manoj153/PersonalKKICADlib/ButterflyBOM.ods

 | Butterfly v.01a
Part | Value | Package | Library | Position | (inch) | Orientation
C1 | 5.6pF 50 V NPO (COG) | 0402-CAP | SparkFun-Capacitors | (0.16 | 0.861) | R180
C2 | 5.6pF 50 V NPO (COG) | 0402-CAP | SparkFun-Capacitors | (0.16 | 0.719) | R180
C3 | 100nF 16 V XR5 | 0402-CAP | SparkFun-Capacitors | (0.175 | 0.175) | R0
C4 | 1uF 16 V XR5 | 0402-CAP | SparkFun-Capacitors | (0.16 | 0.628) | R0
C5 | 10nF 25 V XR7 | 0402-CAP | SparkFun-Capacitors | (0.16 | 0.674) | R0
C6 | 4.7uF 10 V XR5 | 0402-CAP | SparkFun-Capacitors | (0.485 | 0.5) | R0
C7 | 100nF 16 V XR5 | 0402-CAP | SparkFun-Capacitors | (0.485 | 0.55) | R0
C8 | 100nF 16 V XR5 | 0402-CAP | SparkFun-Capacitors | (0.252 | 0.91) | R180
C9 | 100nF 16 V XR5 | 0402-CAP | SparkFun-Capacitors | (0.545 | 0.84) | R90
C17 | 1uF 16 V XR5 | 0402-CAP | SparkFun-Capacitors | (0.23 | 0.35) | R0
C18 | 1uF 16 V XR5 | 0402-CAP | SparkFun-Capacitors | (0.23 | 0.23) | R0
D1 | SBR05U20LP-7 | SBR05U20LP-7 | Kris | (0.29 | 0.345) | R180 | 0.5 A 20 V Schottky Diodes
D2 | SBR05U20LP-7 | SBR05U20LP-7 | Kris | (0.29 | 0.272) | R0 | 0.5 A 20 V Schottky Diodes
D4 | HSP061-2N4 | HSP061-2N4 | Kris | (0.365 | 0.31) | MR270
J1 | 1981584-1 | 1981584-1 | con-usb | (0.3525 | 0) | MR0
JP1 | 1X05_NO_SILK | SparkFun-Connectors | (0.1525 | 1.3525) | R0
JP2 | M02-JST-2-PTH-NO_SILK | JST-2-PTH-NS | SparkFun-Connectors | (0.191 | 0.466) | R270
JP3 | 1X06_NO_SILK | SparkFun-Connectors | (0.0525 | 0.0525) | R90
JP4 | 1X03_NO_SILK | SparkFun-Connectors | (0.4525 | 1.0525) | R90
JP5 | 1X06_NO_SILK | SparkFun-Connectors | (0.6525 | 0.5525) | R270
JP6 | 1X08_NO_SILK | SparkFun-Connectors | (0.0525 | 0.6525) | R90
JP7 | 1X08_NO_SILK | SparkFun-Connectors | (0.6525 | 1.3525) | R270
JP8 | 1X03_NO_SILK | SparkFun-Connectors | (0.5525 | 1.2525) | R270
L1 | BLM15HG601SN1D | 402 | inductors | (0.16 | 0.582) | R0 | 0402 600 Ohms Ferrite Bead |  | http://www.mouser.com/ProductDetail/Murata-Electronics/BLM15HG601SN1D/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
L3 | BLM15HG601SN1D | 402 | inductors | (0.565 | 0.17) | MR180 | 402 600 Ohms Ferrite Bead |  | http://www.mouser.com/ProductDetail/Murata-Electronics/BLM15HG601SN1D/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
R2 | 4K7 | 0402-RES | SparkFun-Resistors | (0.16 | 0.24) | R90
R3 | 1K | 0402-RES | SparkFun-Resistors | (0.337 | 1.157) | R90
R4 | 1K | 0402-RES | SparkFun-Resistors | (0.282 | 1.216) | R180
R5 | 1K | 0402-RES | SparkFun-Resistors | (0.227 | 1.157) | R90
R6 | 10K | 0402-RES | SparkFun-Resistors | (0.53 | 0.175) | R0
RA1 | 22 Ohm 2x resistor array | EXB24V 0404 | Kris | (0.365 | 0.25) | MR0 |  | http://www.mouser.com/ProductDetail/Panasonic/EXB-24V220JX/
SJ1 | SOLDERJUMPERTRACE | SJ_2S-TRACE | SparkFun-Passives | (0.15 | 0.3) | MR90
SJ3 | SOLDERJUMPER-OLDTRACE | SJ_2S-TRACE | SparkFun-Passives | (0.53 | 0.255) | MR0
U$2 | PTS810 SJM 250 SMTR LFS | C&KTACTILESWITCH | Kris | (0.24 | 0.08) | R0 | 1.6 N Black button |  | http://www.mouser.com/ProductDetail/CK-Components/PTS810-SJM-250-SMTR-LFS/
U$3 | PTS810 SJM 250 SMTR LFS | C&KTACTILESWITCH | Kris | (0.46 | 0.08) | R0 | 1.6 N Black button |  | http://www.mouser.com/ProductDetail/CK-Components/PTS810-SJM-250-SMTR-LFS/
U$4 | GREEN | 0402LED | Kris | (0.16 | 0.32) | R90
U$5 | HN01 | HN01 | PWSONN6 | (0.205 | 1.0025) | R0
U1 | STM32L433CCU6 | STM32L433CCU6 | STM32L433CCU6 | (0.3725 | 0.725) | R0
U2 | LUMEX0404RGBLED | LX0404 | Kris | (0.282 | 1.161) | R0 |  | http://www.mouser.com/ProductDetail/Lumex/SML-LX0404SIUPGUSB/?qs=iPumNTI%2f3jXoZkWlWVrBPw%3d%3d
U5 | NCV8170 3V3 150 mA LDO | NCV8170 3V3 150 mA LDO | Kris | (0.23 | 0.29) | R0 |  | http://www.mouser.com/ProductDetail/ON-Semiconductor/NCV8170AMX330TCG/
X1 | ST2012SB 4 pF | ST2012SB32768Z0HPWBB | Kris | (0.156 | 0.79) | R90 | 4 pF only | http://www.mouser.com/ProductDetail/AVX/ST2012SB32768Z0HPWBB/
 | No Substitution please
