manoj153/PersonalKKICADlib/2.1MM BARREL JACK/DC Power Jack 5.5mm x 2.1mm.STEP

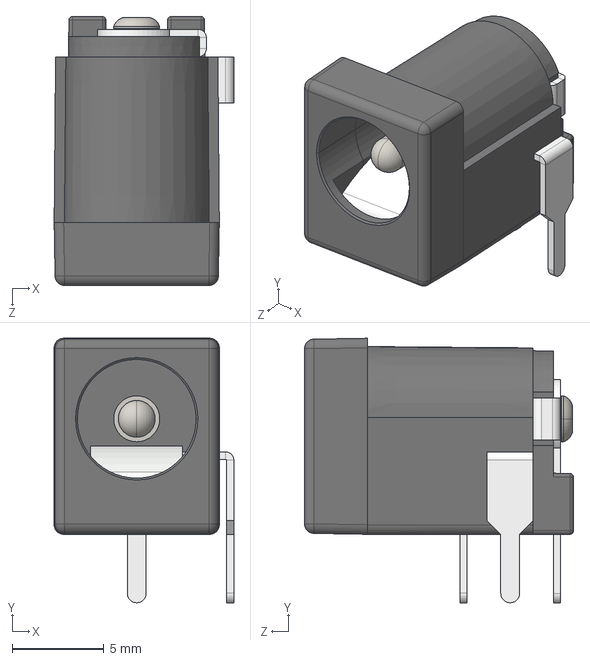
[picture p1: CAD file, 2020-03-30]
2.1MM BARREL JACK/DC Power Jack 5.5mm x 2.1mm.STEP
9.77 x 14.4 x 14.6 mm
