manoj153/PersonalKKICADlib/DRV5032AJDBZR/DRV5032AJDBZR.stp

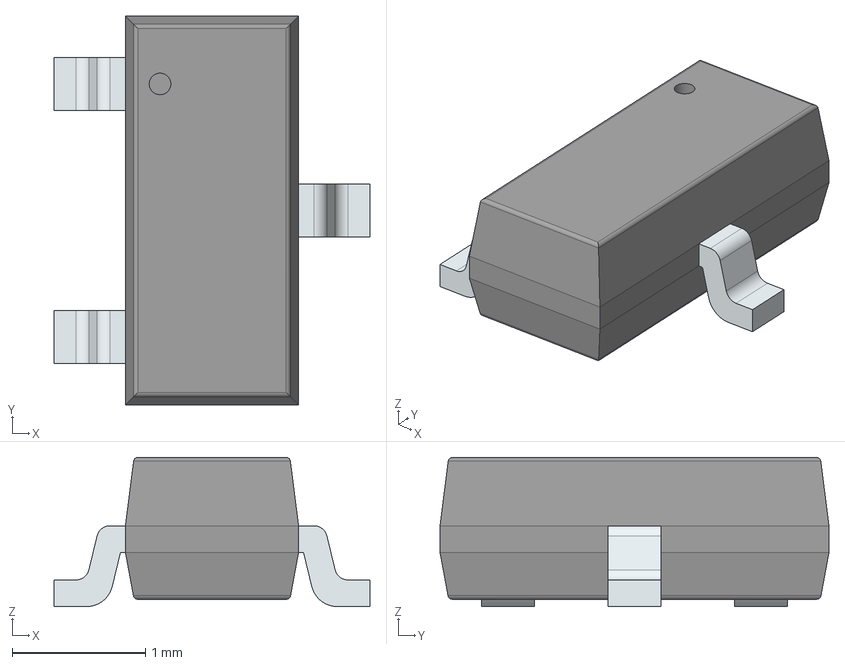
[picture p2: CAD file, 2020-05-10]
DRV5032AJDBZR/DRV5032AJDBZR.stp
2.37 x 2.92 x 1.12 mm
PinsArrayL
FilletPinR
