manoj153/PersonalKKICADlib/ESDA25W/ESDA25W.stl

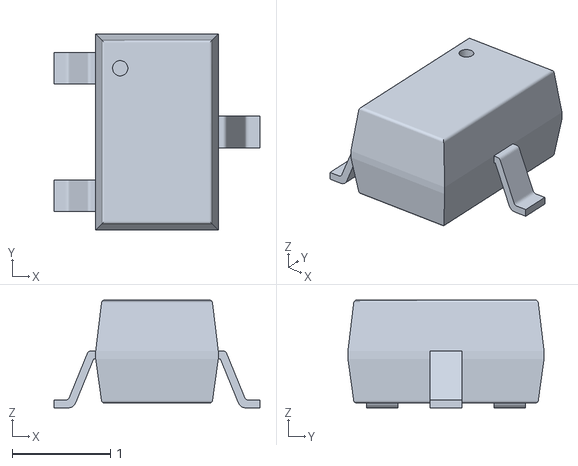
[picture p3: CAD file, 2019-06-10]
ESDA25W/ESDA25W.stl
2.10 x 2.00 x 1.10
