manoj153/PersonalKKICADlib/FUSE-AC/User Library-LF-102071.step

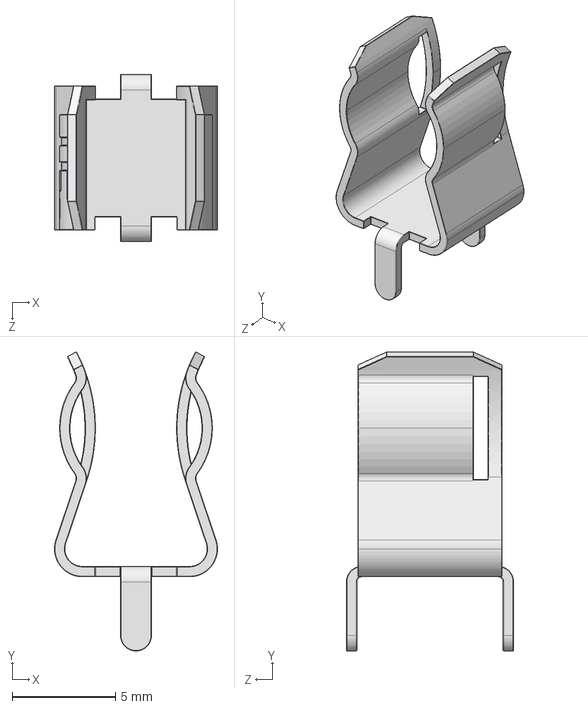
[picture p4: CAD file, 2019-06-16]
FUSE-AC/User Library-LF-102071.step
7.90 x 14.5 x 8.10 mm
