manoj153/PersonalKKICADlib/G6K-2F-Y-DC5/G6K_2F_Y_STEP/G6K_2F_Y.step

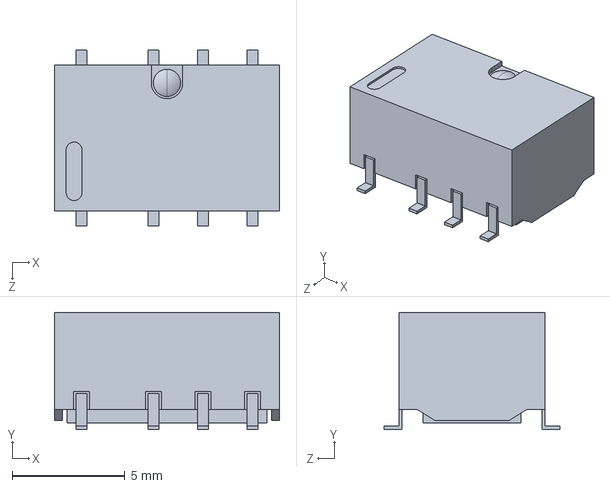
[picture p5: CAD file, 2019-06-10]
G6K-2F-Y-DC5/G6K_2F_Y_STEP/G6K_2F_Y.step
10.0 x 5.20 x 7.80 mm
