manoj153/PersonalKKICADlib/KK254-5WAY/22-05-3051.stp

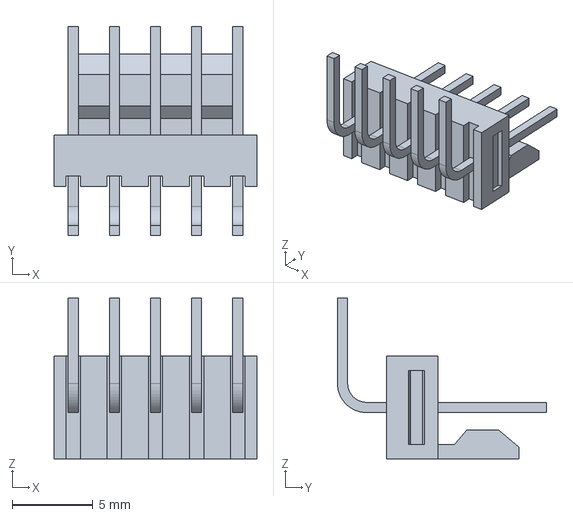
[picture p6: CAD file, 2019-06-10]
KK254-5WAY/22-05-3051.stp
12.5 x 12.9 x 9.93 mm
