manoj153/PersonalKKICADlib/KK254_HORIZONTAL/22-05-7028.stp

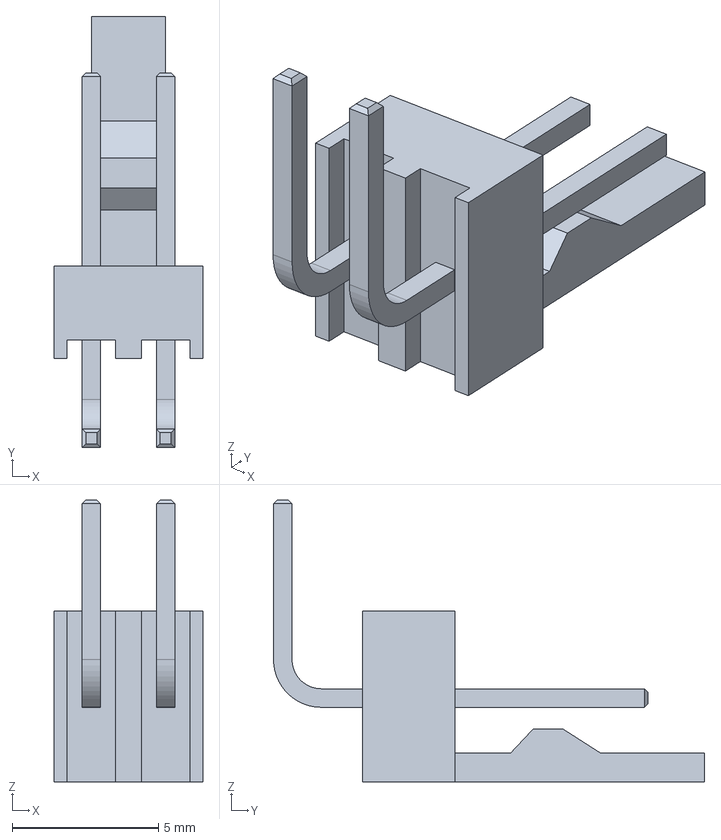
[picture p7: CAD file, 2019-06-10]
KK254_HORIZONTAL/22-05-7028.stp
5.08 x 14.7 x 9.64 mm
