manoj153/PersonalKKICADlib/MT48LC4M32B2P-6A_IT_L_TR/3D/MT48LC4M32B2P-6A_IT_L_TR.stp

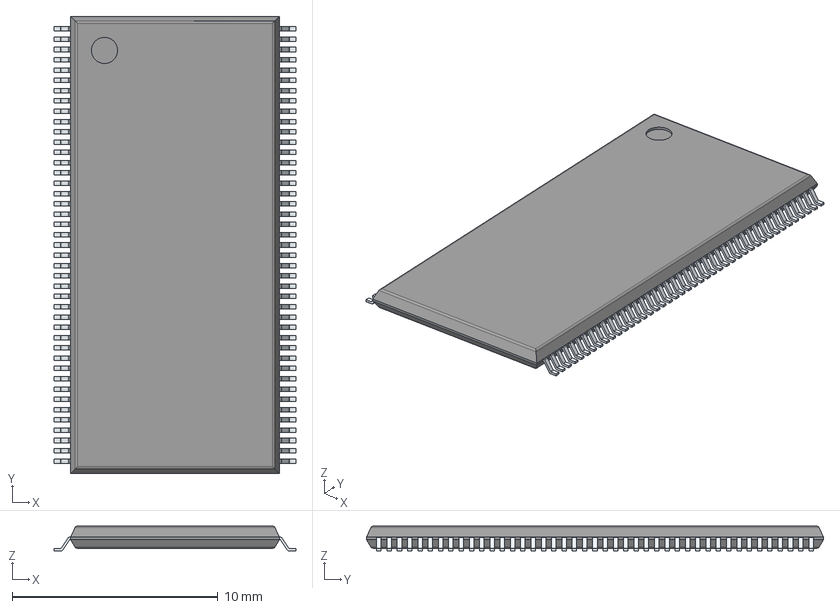
[picture p8: CAD file, 2020-08-13]
MT48LC4M32B2P-6A_IT_L_TR/3D/MT48LC4M32B2P-6A_IT_L_TR.stp
11.8 x 22.2 x 1.20 mm
PinsArrayLR
