manoj153/PersonalKKICADlib/NX3225GD-8MHZ-STD-CRA-3/3D/NX3225GD-8MHZ-STD-CRA-3.stp

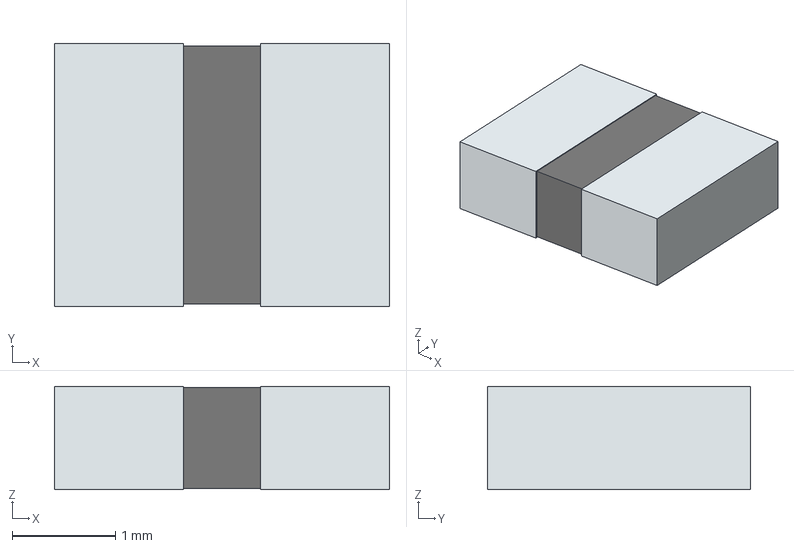
[picture p9: CAD file, 2020-08-13]
NX3225GD-8MHZ-STD-CRA-3/3D/NX3225GD-8MHZ-STD-CRA-3.stp
3.25 x 2.55 x 1.00 mm
term1
term2
