manoj153/PersonalKKICADlib/RZ03-1A4-D005/RZ03-1A4-D005--3DModel-STEP-56544.STEP

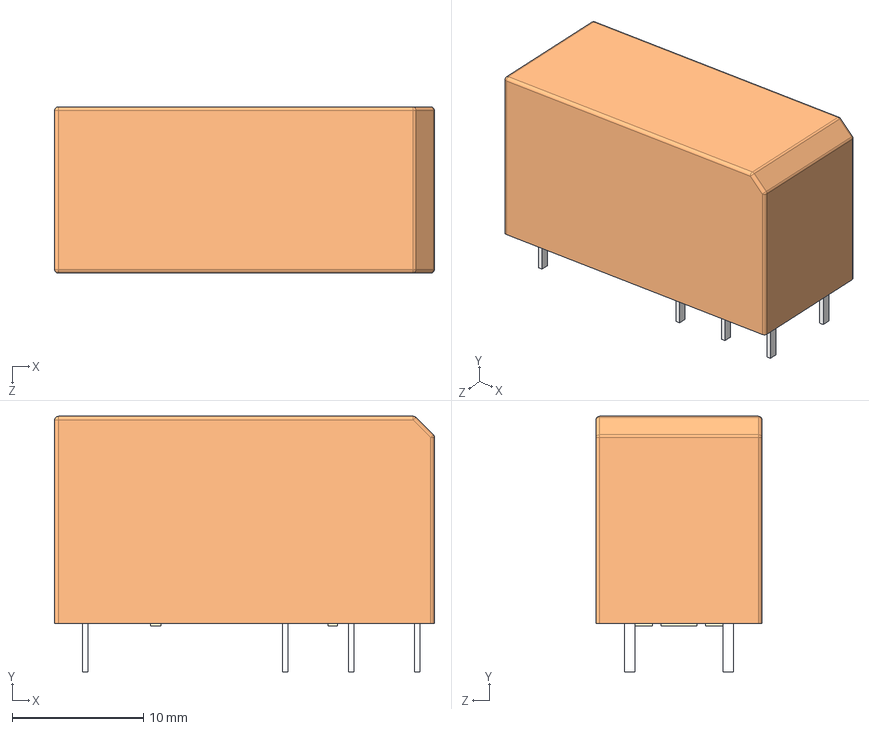
[picture p10: CAD file, 2019-06-10]
RZ03-1A4-D005/RZ03-1A4-D005--3DModel-STEP-56544.STEP
29.0 x 19.5 x 12.7 mm
