manoj153/PersonalKKICADlib/STM32L433CCU6/3D/STM32L433CCU6.stp

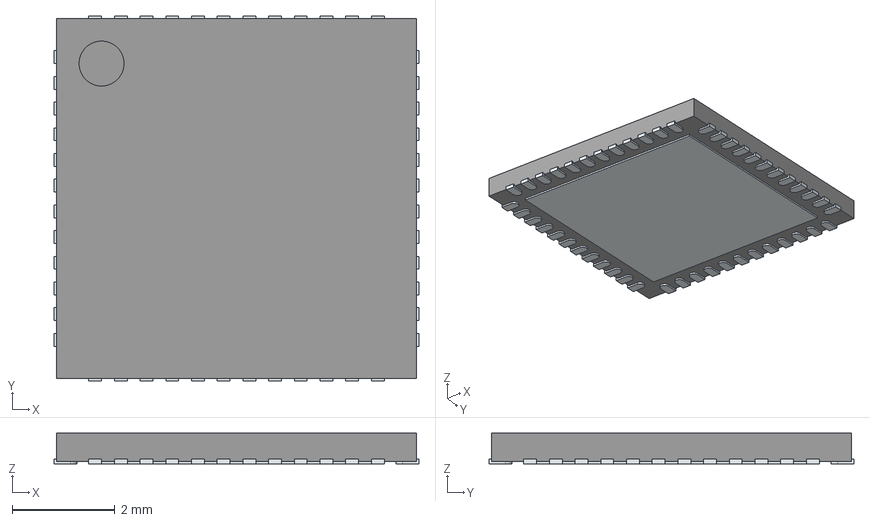
[picture p11: CAD file, 2020-08-13]
STM32L433CCU6/3D/STM32L433CCU6.stp
7.10 x 7.10 x 0.6 mm
ThermalPin
PinsArrayLR
PinsArrayTB
