manoj153/PersonalKKICADlib/TLV3691IDCKR/TLV3691IDCKR.stp

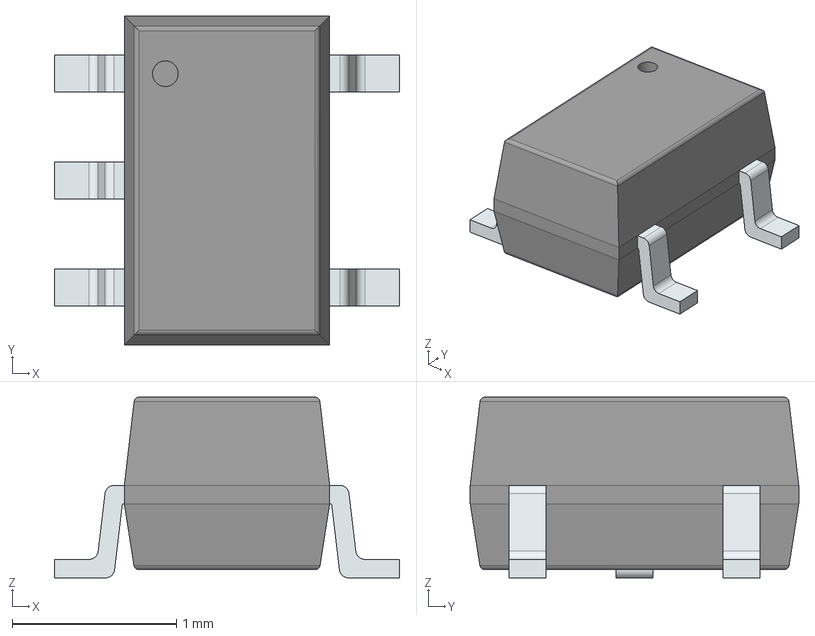
[picture p12: CAD file, 2020-04-08]
TLV3691IDCKR/TLV3691IDCKR.stp
2.10 x 2.00 x 1.10 mm
PinsArrayL
PinsArrayR
