manoj153/PersonalKKICADlib/VS-30BQ015-M3_9AT/VS-30BQ015-M3_9AT.stl

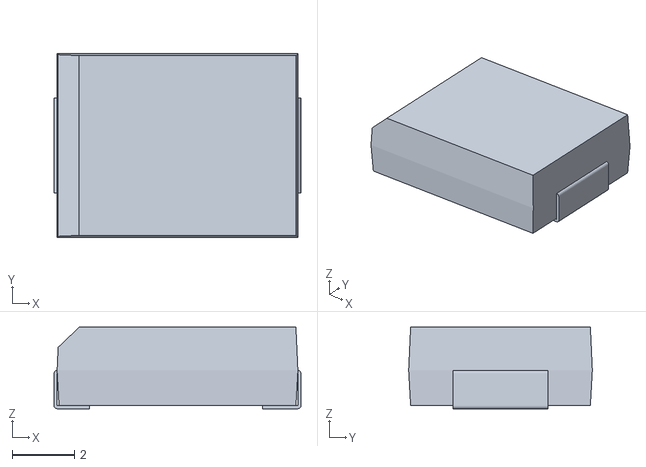
[picture p13: CAD file, 2019-06-10]
VS-30BQ015-M3_9AT/VS-30BQ015-M3_9AT.stl
7.94 x 5.91 x 2.62
