manoj153/PersonalKKICADlib/ws2812b-rgb-led-adafruit-neopixel-1.snapshot.9/WS2812_RGB_LED_updated.stp

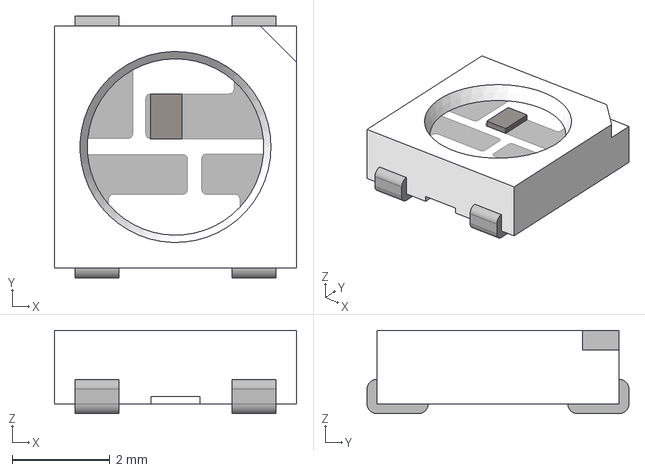
[picture p14: CAD file, 2019-06-10]
ws2812b-rgb-led-adafruit-neopixel-1.snapshot.9/WS2812_RGB_LED_updated.stp
4.95 x 5.35 x 1.70 mm
