manoj153/PersonalKKICADlib/B10B-PHDSS.step

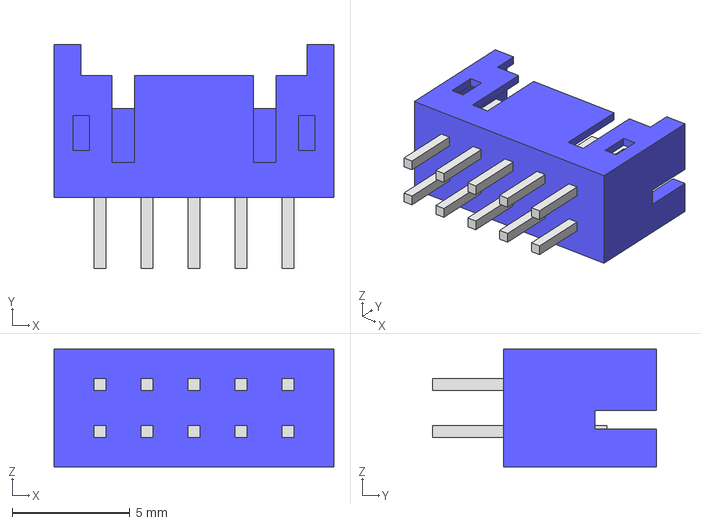
[picture p15: CAD file, 2020-08-13]
B10B-PHDSS.step
11.9 x 9.50 x 5.00 mm
