manoj153/PersonalKKICADlib/B20B-PHDSS.STEP

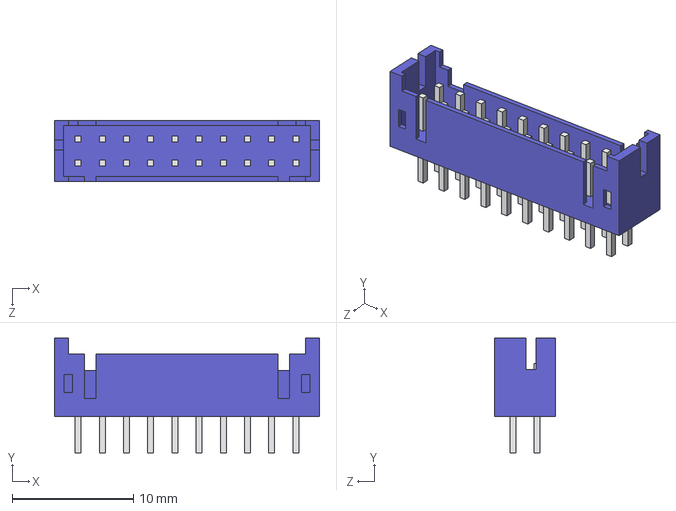
[picture p16: CAD file, 2020-08-13]
B20B-PHDSS.STEP
21.9 x 9.50 x 5.00 mm
