manoj153/PersonalKKICADlib/S2B-ZR.STEP

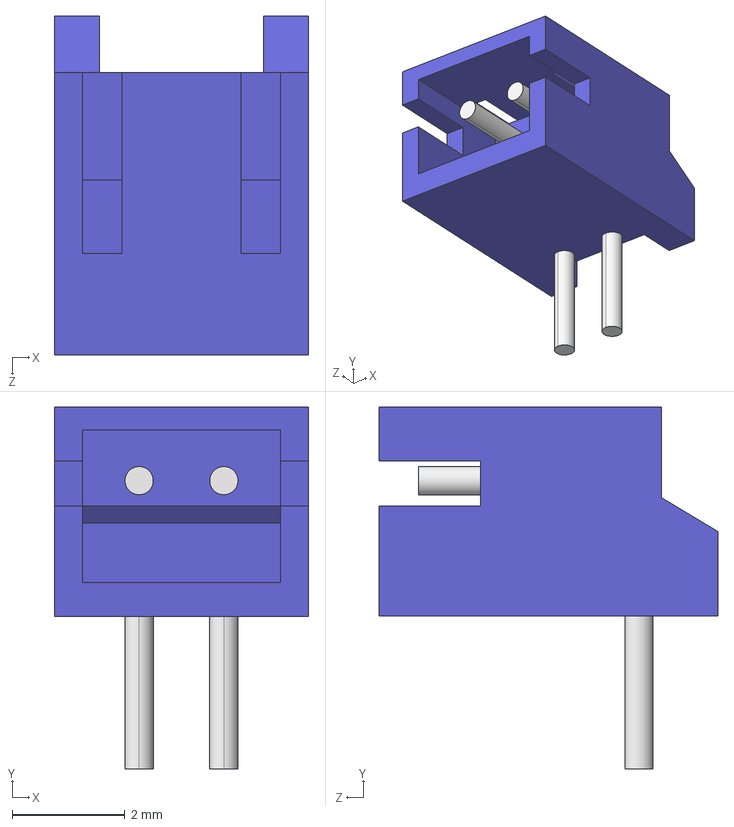
[picture p17: CAD file, 2020-08-13]
S2B-ZR.STEP
4.50 x 6.40 x 6.00 mm
