manoj153/PersonalKKICADlib/LED 5730.stp

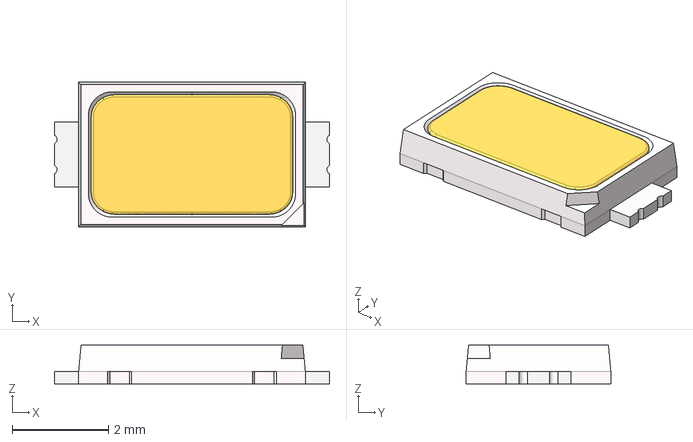
[picture p18: CAD file, 2020-08-13]
LED 5730.stp
5.70 x 3.00 x 0.8 mm
