manoj153/PersonalKKICADlib/B8B-PHDSS.step

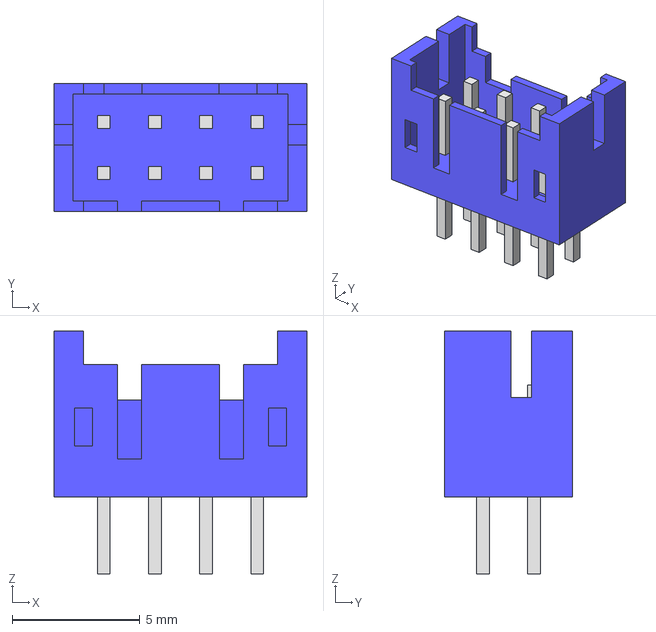
[picture p19: CAD file, 2020-08-13]
B8B-PHDSS.step
9.90 x 5.00 x 9.50 mm
