manoj153/PersonalKKICADlib/LED.step

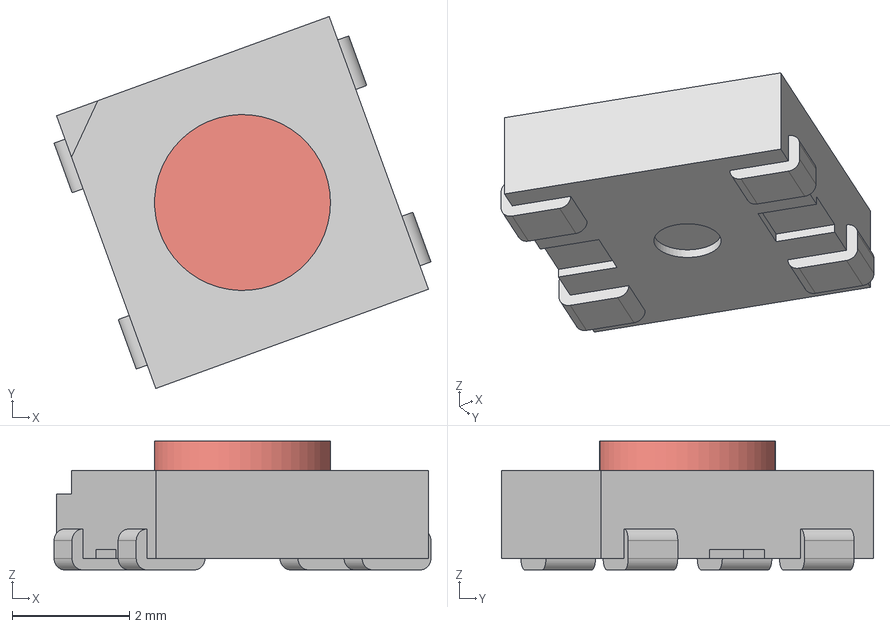
[picture p20: CAD file, 2019-06-10]
LED.step
6.43 x 6.34 x 2.20 mm
