manoj153/PersonalKKICADlib/PCB.dxf

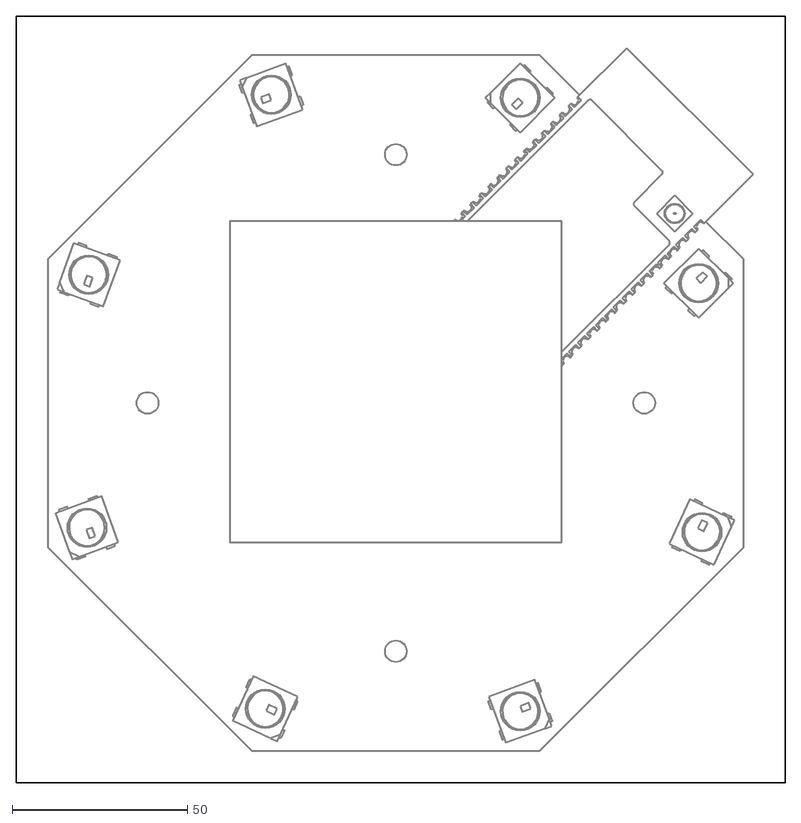
[picture p21: CAD file, 2019-06-10]
PCB.dxf
219.4 x 218.8
