manoj153/PersonalKKICADlib/(list of files, cad)

Other CAD files:
LM4041EIM3X-1.2/LM4041EIM3X-1.2_NOPB.stp
2016L050MR/3D/2016L050MR.stl
2016L050MR/3D/2016L050MR.stp
3P5.08MMTB/1729131.stp
5.08MMTB/1729128.stp
9.5mmTerminalBarrier/User Library-Screw terminal block 9_5mm.step
DRV5032AJDBZR/DRV5032AJDBZR.stl
JST_S2B-ZR_LF__SN_/Allegro/s2b-zr.psm
JST_S2B-ZR_LF__SN_/DEHDL/s2b_zr_lf__sn_/chips/chips.prt
MAX30205MTA.STEP
MT48LC4M32B2P-6A_IT_L_TR/3D/MT48LC4M32B2P-6A_IT_L_TR.stl
NX3225GD-8MHZ-STD-CRA-3/3D/NX3225GD-8MHZ-STD-CRA-3.stl
NX3225GD-8MHZ-STD-CRA-3/Allegro/resc3226x100n.psm
NX3225GD-8MHZ-STD-CRA-3/DEHDL/nx3225gd_8mhz_std_cra_3/chips/chips.prt
STM32L433CCU6/3D/STM32L433CCU6.stl
STM32L433CCU6/Allegro/qfn50p700x700x60-49n-d.psm
STM32L433CCU6/DEHDL/stm32l433ccu6/chips/chips.prt
TLV3691IDCKR/TLV3691IDCKR.stl
ws2812b-rgb-led-adafruit-neopixel-1.snapshot.9/WS2812_RGB_LED_Updated.igs
ws2812b-rgb-led-adafruit-neopixel-1.snapshot.9/WS2812b Updated.prt
ws2812b-rgb-led-adafruit-neopixel-1.snapshot.9/WS2812b updated.x_t
