manoj153/PersonalKKICADlib/(commit log)

2019-06-16 add fuse,symbolSilkscreen,terminalBlocks
    [User Library-LF-102071.step, User Library-Screw terminal block 9_5mm.step]
2019-08-09 FPC, ESP32WROVER,LMR10510 ETC UPDATED
2020-03-30 made a small changes over generic footprint, i think rltd to laser IC
2020-03-30 added esp wrover footprint and 3d step
2020-03-30 added barrel jack 2.1 step file
    [DC Power Jack 5.5mm x 2.1mm.STEP]
2020-04-02 added DRV2605L
    [DRV2605LTDGSRQ1.stl, DRV2605LTDGSRQ1.stp]
2020-04-08 not clean, later clean up by unstaging maybe
    [LM4041EIM3X-1.2_NOPB.stl, LM4041EIM3X-1.2_NOPB.stp, TLV3691IDCKR.stl, TLV3691IDCKR.stp]
2020-05-10 added all the library i used
    [DRV5032AJDBZR.stl, DRV5032AJDBZR.stp]
2020-07-10 added TPS6116 backlight driver used on zeus multimedia
2020-08-13 random hantam all git add
    [B10B-PHDSS.step, B20B-PHDSS.STEP, B8B-PHDSS.step, ButterflyBOM.ods, EDI2CAP.CFG, LED 5730.stp, MAX30205MTA.STEP, MT48LC4M32B2P-6A_IT_L_TR.stl]
2020-08-25 added own custom power flags
2020-08-26 added bq GNDA and 4.8V specifically for charger
2020-08-27 ADDED TPS GNDA
2020-08-30 ADD ESP32 AND STM32 POWER FLAG REGULATED
2020-08-30 change pin type of vout to power output to solve DRC
2020-09-01 bq to set SYS as power output to solve DRC
2020-09-03 add stm32 own lib to solve DRC conflicts
2020-09-09 draw 470uF foot print and add to lib
2020-09-09 add TPS61088RHLT footprint
2020-09-09 TPS61088RHLT adopted for hand-soldering
2020-09-09 add thermal via to allow solder suck in
